ttocali/rssi-raspi/Website/Final Report/README.txt

Alpha by HTML5 UP
html5up.net | @n33co
Free for personal and commercial use under the CCA 3.0 license (html5up.net/license)

A clean, super minimal responsive template geared towards startups, app devs, and other
dedicated folks working tirelessly to launch their products. Includes a landing page,
generic page, contact page, and a page with a whole mess of pre-styled elements (something
new I'm trying out). Sass sources are also included.

Demo images* courtesy of Unsplash, a radtastic collection of CC0 (public domain) images
you can use for pretty much whatever.

(* = Not included)

Feedback, bug reports, and comments are not only welcome, but strongly encouraged :)

AJ
n33.co @n33co dribbble.com/n33

PS: Not sure how to get that contact form working? Give formspree.io a try (it's awesome).

Credits:

	Demo Images:
		Unsplash (unsplash.com)

	Icons:
		Font Awesome (fortawesome.github.com/Font-Awesome)

	Other:
		jQuery (jquery.com)
		html5shiv.js (@afarkas @jdalton @jon_neal @rem)
		CSS3 Pie (css3pie.com)
		background-size polyfill (github.com/louisremi)
		Respond.js (j.mp/respondjs)
		Skel (skel.io)
