ttocali/rssi-raspi/Website/Final Report/index.html

# On-Campus Lost and Found by Christine Hwang and Tania Tocalini

## On-Campus Lost and Found

Christine Hwang (ch458) and Tania Tocalini (tvt9)
May 18th, 2016

## Objective

Our objective was to design and implement indoor localization with the Pi. We accomplished this goal through Wi-Fi using fingerprinting. Because universities have broad Wi-Fi networks, we decided that indoor localization would best be used to help users detect which floor and building their lost objects are in.

## Introduction

Indoor Wi-Fi localization is a fascinating topic to research as there are so many different ways to implement it. Since the Raspberry Pi is a powerful computer, we believed that it would be a good tool to discover how to implement an indoor positioning system. Having a working indoor positioning system on campus would also be incredibly useful if we could apply it to locating easily lost items such as umbrellas, wallets, or keys. For our current goals, we chose to design a system that would be able to identify which building and floor the item is located in. This system would use a client-server model with the Raspberry Pi as the main server and Wi-Fi tags on the lost items as the clients. For the client-side, we used the Huzzah breakout board provided by Adafruit as the tag. For the server-side, we executed indoor localization with fingerprinting after researching and considering several different methods. As proof of concept, we have implemented a system that can only detect one lost item in Phillips Hall for now but we hope to be able to expand this system to be able to detect multiple lost items campus-wide.

## Design and Testing

### Background Research

Because there are so many ways to implement indoor localization through Wi-Fi, we took some time to research which method was most feasible for our purposes. Specifically, we investigated the methods of Wi-Fi trilateration, triangulation, distance-vector hop node localization and scene anaylsis for fingerprinting. Written below are simple overviews of each of these localization methods. For more details on trilateration, triangular and scene analysis, refer to Martin van de Goor's paper (http://www.cs.ru.nl/D.Jansen/MartinVanDeGoorScriptie.pdf). For more details on Distance-Vetor Hop Node localization, refer to Anil Agashe, Amrita Agashe, and Dr. Patil's paper (http://ieeexplore.ieee.org/stamp/stamp.jsp?arnumber=6295757).

#### Trilateration

For two dimensions, trilateration determines an object's position using the intersection of the object's distances from three access points in the same plane. With Wi-Fi, the distances can be calculated using the free-space path loss concept from physics. As discussed in Ryan Miller's blog (http://rvmiller.com/2013/05/part-1-wifi-based-trilateration-on-android/), the free-space path loss is a relation between the distance and the RSSI (Received Signal Strength Indicator) and frequency of the signal from the access point as seen in the Equation 1. Note that the constant -27.55 depends on the units. For this equation, we are assuming that frequency is in MHz and distance is in meters.


Equation 1: Free-Space Path Loss

Typically, the distances from the nodes are assumed to be circles for more accuracy, but can be done using squares as well for simpler computation.

#### Triangulation

Triangulation is similar to trilateration, but instead of requiring distances between the object and three nodes, it requires one known distance between two nodes and the angles between each of these nodes and the object. In Wi-Fi triangulation, the measurement of the angle can be determined with the angle of arrival (AoA) method. The AoA method requires that the nodes measure the difference in arrival times of a signal and also needs to know the geometry of the node array.

#### Distance-Vector Hop Node Localization

Also known more commonly as the DV-Hop, this algorithm returns the distance of unknown objects to known nodes by computing the product of the average hop distance and the hop count. Trilateration can then be used to estimate the position once three of these distances have been computed.

#### Main Drawback to These Methods

The main drawback to the previous methods is that they all require knowing the physical location of the access points on campus. Interestingly enough, there actually are potential databases that we could use to find the location of a router shown in the table borrowed from Wikipedia's Wi-Fi Positioning System (https://en.wikipedia.org/wiki/Wi-Fi_positioning_system#Public_Wi-Fi_location_databases) page.

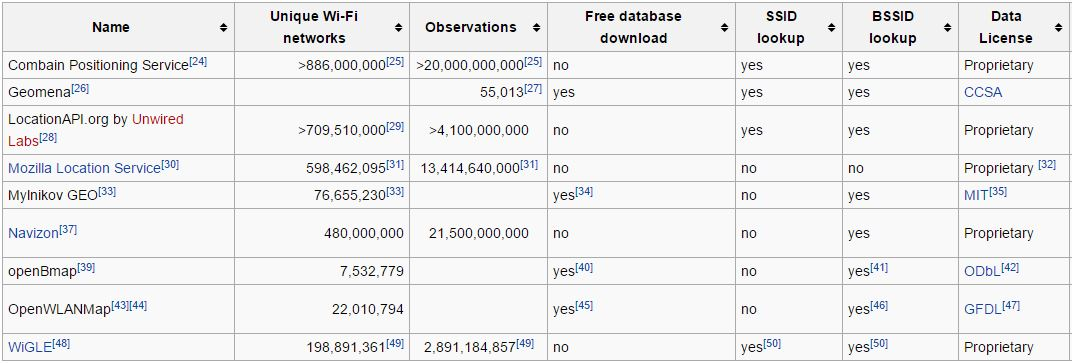
[picture p1: Website/Final Report/images/DatabaseTable.JPG]

Figure 1: Public Wi-Fi Location Databases

Unfortunately, none of these available databases allowed us to access the exact location of the access points. Instead, they were all blackbox APIs that returned an approximate locations, which were useful to determine the building the object is in but nothing more specific than that, which is why we ended up using the last method of scene analysis or fingerprinting as that was the most feasible. Note, only some of the databases were viable because their API allowed us to look up locations based on BSSIDs we collect from the access points.

#### Scene Analysis and Fingerprinting

Scene analysis determines a location based on what can be sensed or observerd around the target. This requires a learning phase before any localization can be done. The learning phase generally collects and maintains a database of the categorized observed information. In our case, we used fingerprinting to collect data on router WiFi access points. Fingerprinting essentially takes a snapshot of the observed data and labels it with the appropriate tag, e.g. location such as Phillips Floor 2. The more fingerprints you have the larger the scope of analysis can be and more accurate you can determine location. In the localization phase, scene analysis then takes in everything the target is observing and matches it against the recorded fingerprints to find the location of the target. We decided to use this to design our system because we had no information on the location of routers. With this system we could collect fingerprints and assign each to a general location. Thus, during the learning phase, we "learned" the locations of the routers. Afterwards we were able to use this to determine the location of the target.

### Overview

The On-Campus Lost and Found works as a client-server model. Each easily lost item would be attached with a Wi-Fi tag (shown in Photo 1) that would act as the client by observing the networks around it and sending necessary data to the Pi server.

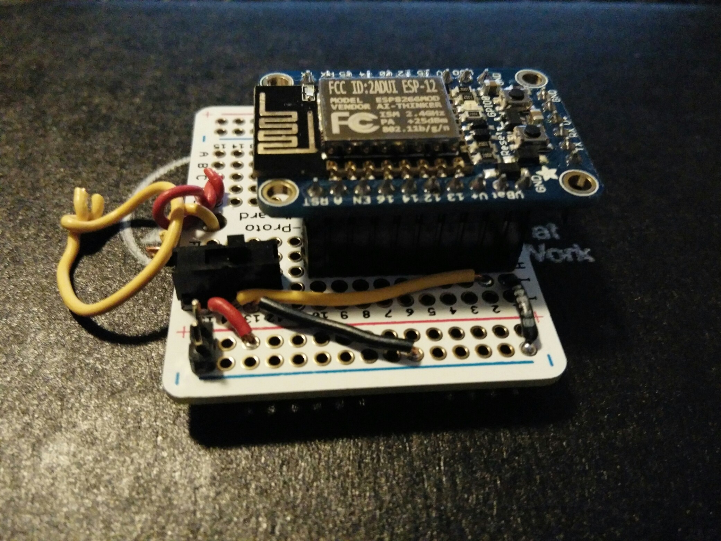
[picture p2: Website/Final Report/images/HuzzahTag.jpg]

Photo 1: Wi-Fi Tag

As discussed in the previous section, the system has two states: a Learning state and a Tracking state. Both states follow the same model in Figure 2.


Figure 2: Overview of On-Campus Lost and Found

#### Learning

Before the Pi can locate any lost item, it needs to map out the necessary buildings. In order to do this, the server has to be configured into the Learning state. The server will then ask the user for the building and floor. After answering this question, the user needs to walk around the desired floor with the tag. As they walk, the tag will send an array every two seconds of the IP address of the Huzzah and the BSSIDs of the three networks around the tag with the strongest RSSI signals as well as the RSSI signals themselves. The server will then store this information in a database matching the combination of BSSIDs and RSSIs to a floor. This will need to be done for each building and each floor the user wishes to map.

#### Tracking

When the user is satisfed with their mapping, they can then start tracking their item. While the system is idle, the server would simply display a red button labeled "PANIC!" as the user supposedly hasn't lost their item yet. When the user has lost their item, though, they will then press the button in panic. Hopefully, their item is still on campus and if so, then the server will be able to locate the item and display the building and floor on the screen by querying the newly made database. Once the item has been relocated, the user can reply to the server that they have found the item by hitting the "I'm OK" button. This will return the server to the idle state again. These two server states can be seen in Photo 2.

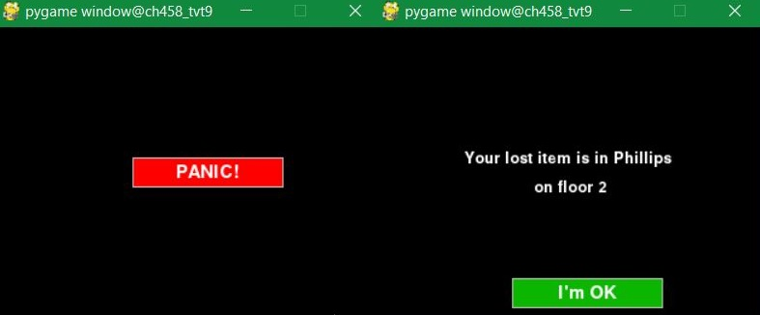
[picture p3: Website/Final Report/images/ServerStates.jpg]

Photo 2: Pi Server Before and After Item is Lost

### Server-Side

There are 4 main components on the server-side for this system: communication layer, fingerprint database, graphical user interface, and modes of operation, i.e. learning and tracking.

In the communication layer, we currently have a simple socket connection server, hosted on the Raspberry Pi. It expects communication following UDP protocol. We chose UDP over TCP because we had planned on having fast continuous communication between the server and client. Assuming the item has been lost and isn't moving, we don't need to know every single snapshot of data. As long as we receive semi-frequent data, the server is able to approximately locate the client. We can afford to trade off reliability of data and connection for speed and simple design. We discovered that on public WiFi networks, such as RedRover, we are able to piggyback the network and bypass registration to still use the WiFi for socket communications with our server. We did nothing extra to make this happen. It simply worked once we set up a socket communication. Note, if you try to access web pages without registration, you won't get the contents of the web page, but instead a message asking the user to register.

The most critical portion of this system is the fingerprint database. We use a database to keep track of router WiFi access points within a mapped area. During the learning phase, we collect BSSID and the associated RSSI, building name, and floor number. The database then creates a table for each mapped building. BSSIDs are assumed to be a unique entry for each table, so we use this fact to quickly find information about any access point. For each entry we keep the average of encountered RSSI signal strength for a floor and the number of times we have encountered this WiFi access point. Keeping the average helps to stabilize our information for each access points by eliminating outliers caused by an obstacle-free line of sight for a signal. We currently keep track of the number of times we encounter an access point, but don't use this information in our analysis. The plan for the future was to design a finer grain algorithm that would be based on a combination of RSSI, number of times encountered, and locations of analysis. We also keep track of the floor for each BSSID. The floor number is determined by the RSSI. The floor with the highest RSSI is the one that wins and is put into the database. Note, this does not imply that the router is actually on that floor. It simply means that if we were to receive a signal from that WiFi point again, we're most likely to be on the stored floor. Overall, our "fingerprint" consists of a BSSID with the associated RSSI, number of times seen, and floor number. Fingerprints are aggregated per building in our database. This was written and maintained using sqlite.

As shown in a previous section, we designed a graphical user interface for tracking an item. The interface is designed to display the location of the item, whenever the user chooses to see the location. Otherwise, the GUI is idle and doesn't display any useful information.

Our backend has three modes of operation: learning, tracking, and idle. Both learning and tracking were described in previous sections. Both operations are executed separately from the server. The server can then be on and running no matter the mode of operation. We use a fifo between the server and the operations to communicate data from the server to the algorithms. The learning script may update the database based on the data passed on from the server. The tracking script will under no circumstances update the database. It simply takes the BSSID passed on from the server and queries the database to get the corresponding building and floor.

### Client-Side

#### Hardware

The tag we use to scan the surrounding networks is Adafruit's Huzzah breakout board (https://www.adafruit.com/product/2471). As seen in the photo below (borrowed from the Adafruit website), it's about the size of a quarter, a good size to use for a tag.

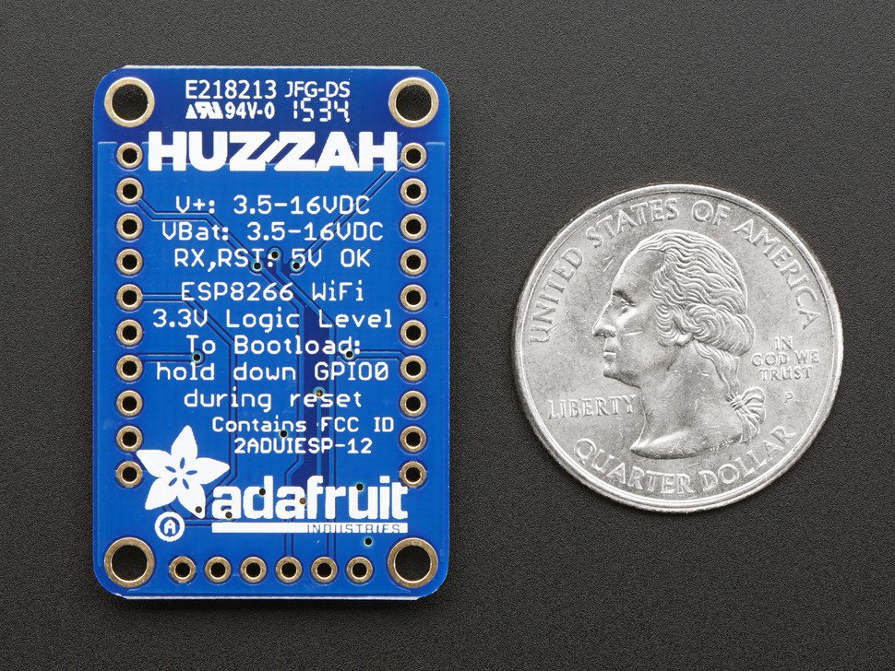
[picture p4: Website/Final Report/images/2471-13.jpg]

Photo 3: Comparison of Huzzah Board to Quarter

After receiving the Huzzah, we soldered the headers onto the board. By accident, we soldered the programming header incorrectly. Instead of facing upwards from the board, we soldered it facing downwards similar to the other two headers. This made it impossible to put it into a breadboard unless the Huzzah was placed at the edge. This later turned to be a benefit, however, by reducing the height of the tag.

Since this was a tag separate from the Pi, the Huzzah needed its own power supply. For power sources, we were originally going to use coin batteries because they were small, light and cheap. However, we were afraid that the coin batteries would not be able to supply enough current to the Huzzah. According to Adafruit's tutorial (https://learn.adafruit.com/adafruit-huzzah-esp8266-breakout/pinouts), the Huzzah needed a supply that provides at least 3.3V and 500mA of current, so we decided to buy a 3.7 lithium ion polymer battery (https://www.adafruit.com/products/1578) that could supply up to 500mA. The reason we did not consider using a typical 6V AA battery pack is because they are too heavy and would have weighed the tag down compared to the much lighter lithium ion battery. An additional note about the lithium ion battery is that they can be recharged and reused as long as you have the corresponding charger (https://www.adafruit.com/products/1904).

To keep the tag portable, we bought the smallest perfboard available (https://www.adafruit.com/products/1608) (1/4 size). On the front side of the board, we soldered two 10-pin female-to-male headers to attach the Huzzah to the board, a SPDT switch to control the power supply, a 2-pin male header to connect the battery to the board, and wires to connect the power supply to their respective pins on the Huzzah (mainly the VBat and GND pins). We used headers to connect the Huzzah to the perfboard instead of directly soldering the Huzzah to the board so that the Huzzah would be easy to replace in the case that we accidentally killed the chip. On the back side of the board, we put velcro so that the battery can be easily attached. We also inserted wires into one of the mounting holes of the perfboard and molded them into a key ring as a possible idea on how to attach the tag onto an item. The final product turned out to be a portable tag with a size of 1.7" x 2.0" x 0.9" that can easily be turned on and off as seen in the following photos.

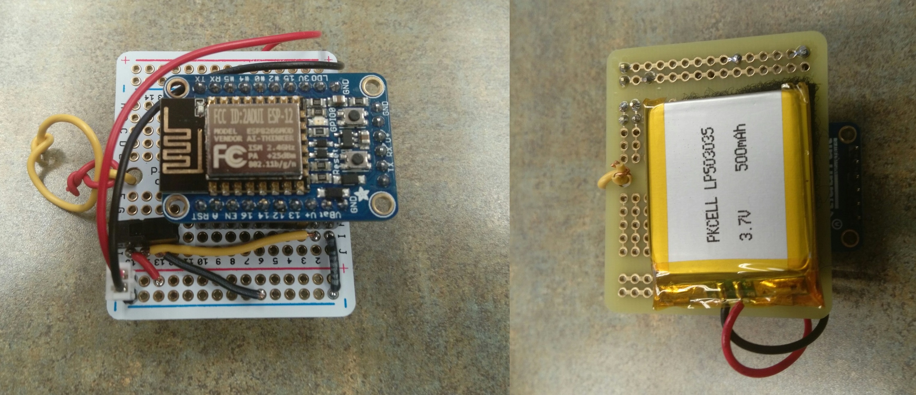
[picture p5: Website/Final Report/images/HuzzahBothSides.jpg]

Photo 4: Huzzah Tag Front and Back Sides

#### Software

There are two main methods to program the Huzzah: NodeMCU Lua and the Arduino IDE. Due to familiarity and simplicity of use, we programmed the Huzzah with a USB to TTL Serial Cable (https://www.adafruit.com/product/954) and the Arduino IDE (https://www.arduino.cc/en/Main/Software). The client code written for this project is attached in the Code Listings section of the Appendix as Client.ino.

As mentioned earlier, the tag needs to be able to send an array containing its current IP address and the BSSIDs of the top three routers and their corresponding RSSIs to the server every 2 seconds. Convieniently, the Huzzah is an ESP8266 chip and therefore comes with the ESP8266WiFi library, which includes many functions needed for this project. In particular, we found the WiFi.scanNetworks() and WiFi.getNetworkInfo() functions to be useful.

During initialization, the Huzzah will boot up and first connect to the university's main network. In our case, we connect the tag to Cornell University's RedRover Network as it is one of the largest open networks on Cornell. Once connected, it will then connect to the server and then obtain and store its current IP address into the client array. It will also setup an LED to blink every 30 seconds. The purpose of the LED is to check on the battery life. If the power supply is below 3.3V, the Huzzah won't function correctly and so the LED will fail to flash.

After everything is set up, the Huzzah will proceed to enter a loop. It scans the networks using WiFi.scanNetworks to record the number of discovered networks. Then, it will get various information through the WiFi.getNetworkInfo() function about each network namely the SSID, encryption type, RSSI, BSSID, channel, and whether the network is hidden or not. For this project, we are mainly concerned about the BSSIDs and RSSIs and so we store these values into two large arrays containing the BSSIDs and RSSIs of all the networks. While this program runs, the Huzzah needs to be able to identify the three networks with the strongest signals. When scanning the networks, though, the returned list of networks may not necesarily be in any specific order. Thus, we perform an insertion sort (as we are not too concerned about speed in the program) to sort all the RSSIs and their corresponding BSSIDs in order from strongest to weakest signal to record the top three BSSIDs. After the top three networks are found, the Huzzah stores these BSSIDs and RSSIs into the large client array as seen in Figure 2 and then sends this array to the Pi server.


Figure 2: Format of Client Array (34 bytes total)

### Testing

Testing the project initially was straightforward. As this was a software-heavy project, we mainly printed variables to the screen to debug the code. Note that on the Huzzah side, these prints must be commented out once debugging is completed. If not, the Huzzah program will not run when unplugged from the computer because it won't be able to connect to the serial monitor.

Testing the actual implementation was more complex. Before the Pi can track anything, it had to learn a building first. For verification purposes, we used floors on Gates and Phillips Hall. Since there were some server-client communication issues, one person would roam the floor with the Huzzah. On the other side, the second person would keep an eye out on the command line to ensure that no communication errors happened between the Huzzah and the Pi. If a problem did arise, the second person would contact the first person by phone to let them know that they can stop. Communications between the Huzzah and Pi would then be reset so that the first person can continue their fingerprinting quest. Similarly, for tracking, one person would be walking around with the Huzzah while the second person would be at the server. The server would print the determined location of the Huzzah. We could easily verify whether the system was working then by seeing if the determined location matched the actual location.

### Issues

While we were working on this project, we did encounter several mysterious issues dealing with the Pi and Huzzah. Sadly, we were not able to diagnose the cause nor come up with a fix for most of these issues.

One of the main issues was when our first Pi had mysteriously died. This occured after we had plugged it into one of the walls in Statler For troubleshooting the Pi, we referred to elinux's R-Pi_Troubleshooting (http://elinux.org/R-Pi_Troubleshooting) page. The Power LED didn't light up for this Pi after plugging it into Statler and when we attempted to communicate with the Pi through the FTDI cable, the computer claimed that there was the Pi required too much power that the USB port couldn't provide. We suspect that the Pi may have died after a power surge in Statler, but are unsure if that is the true source.

Hence, we obtained a second Pi, but this Pi turned out to be faulty as well. Even though the Power LED lit up this time, the ACT LED did not flash as it was supposed to show SD card interaction and instead remained on after the Pi booted. The piTFT display also remained lit up and never booted. We isolated the problem as the Pi itself. To eliminate other possible causes, we plugged it into the monitor to remove the piTFT screen and we input in a SD card that had worked on another Pi, but this Pi still did not boot up. As this Pi was a new Pi, we believe that the Pi may have been defective right out of the box.

Now that we had two Pis dead, we found that our touchscreen had completely died as well. Actually, the touchscreen had been a constant issue before this project. In a working system, /dev/input/touchscreen would be mapped to event2. Ours, though, had a tendency to map to rfkill. This issue used to be alleviated by running a Bash script in the .profile that would ensure that /dev/input/touchscreen was mapped to event2, but this script stopped working as the Pi would display that the only thing /dev/input/touchscreen would map to was rfkill. Even after we obtained a new piTFT screen, we were unable to fix the problem. We speculate that the cause may be somewhere in the configuration stored on the SD card, but were unable to fix it in time to make our touchscreen GUI work for the demo.

Another bug that we had was miscommunication between the Pi and Huzzah. When the Huzzah is turned on, we expected that it would automatically connect with the server if the server is online but it doesn't. Instead, we needed to leave the Huzzah on, close and reopen the server, and reset the Huzzah to restore communications. It is still unknown whether this issue is due to the server or due to the client.

The final unsolved issue was transferring variables between Python files. We wanted to be able to identify the correct building and floor in tracking.py and reveal this location on the screen in gui.py. According to the Python FAQ (https://docs.python.org/2/faq/programming.html#how-do-i-share-global-variables-across-modules), we simply had to write a third module and import it in both files to have global variables between modules, which is why our code also includes a location_me.py. Despite following the instructions, though, the variables in location_me.py remained unchanged in gui.py even though they were changed in tracking.py. Without being able to connect the two modules, we were unable to complete the desired GUI for this project even without the touchscreen functioning.

An issue early on that we had and were able to solve was getting the Huzzah to connect to Cornell University's RedRover Network. Following Cornell's instructions on how to register a device without a browser (http://www.it.cornell.edu/services/wifi/register-nobrowser.cfm), we found that the Huzzah was still unable to connect to the network correctly. Below are some images detailing a successful connection versus the unsuccessful connection to the Internet. Luckily, we did not need to worry about this issue too much, because we could still connect to the server through a direct socket connection despite not being able to connect to the Internet. After some further reflection, it is possible that we registered the wrong MAC address. While testing our project, we found that the Arduino examples printed the obtained BSSIDs in reverse so this may be the case as well with the MAC address.

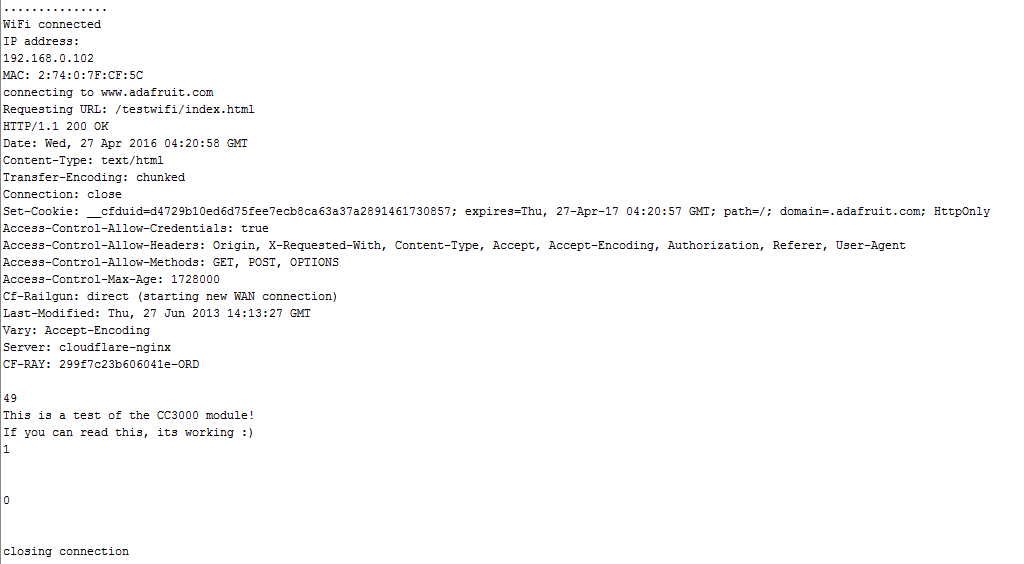
[picture p6: Website/Final Report/images/successful_connection.PNG]

Figure 3: Successful Connection Between Huzzah and Network

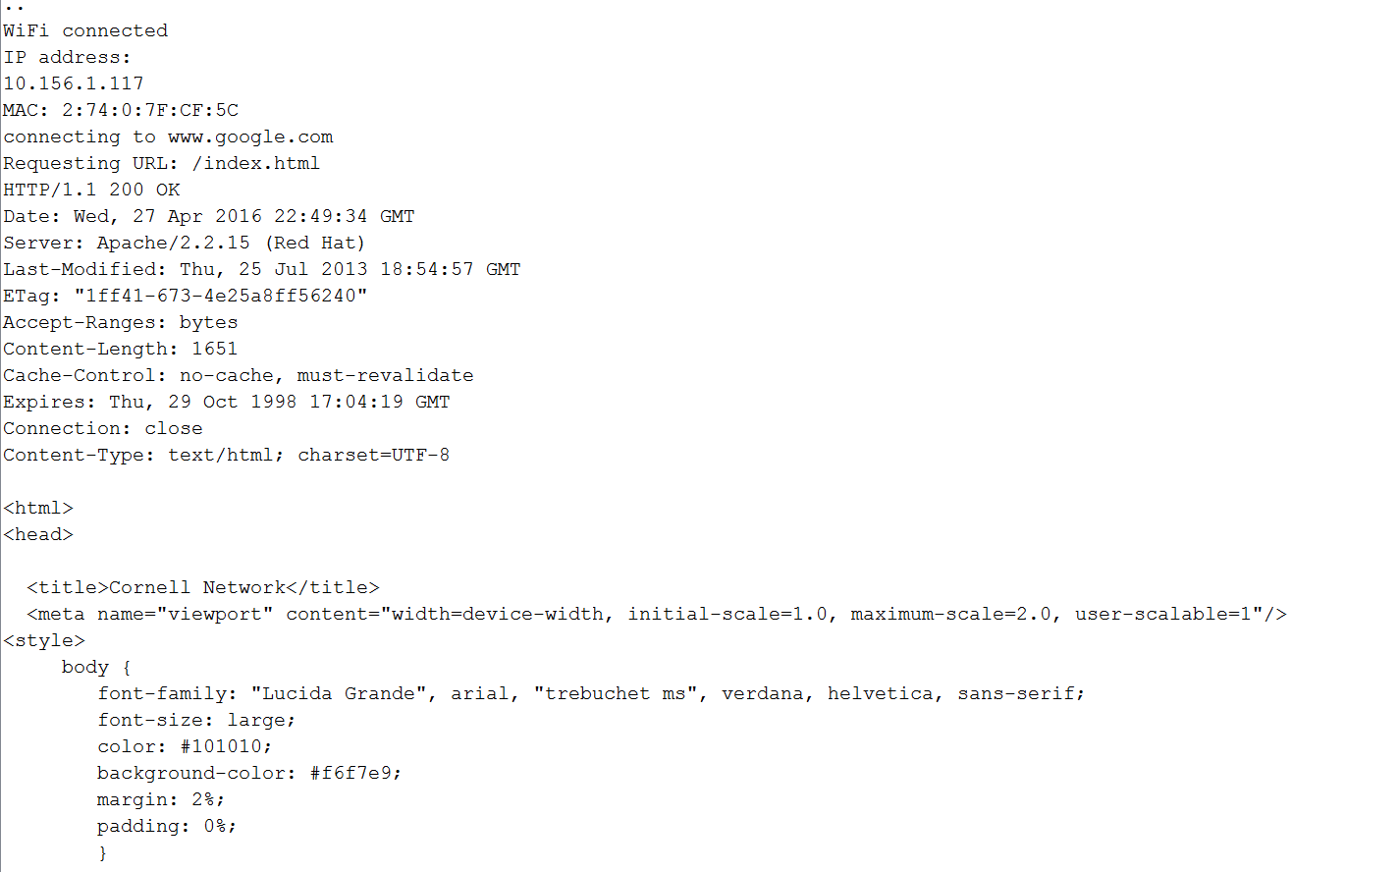
[picture p7: Website/Final Report/images/failed_connection.PNG]

Figure 4: Failed Connection Between Huzzah and Network

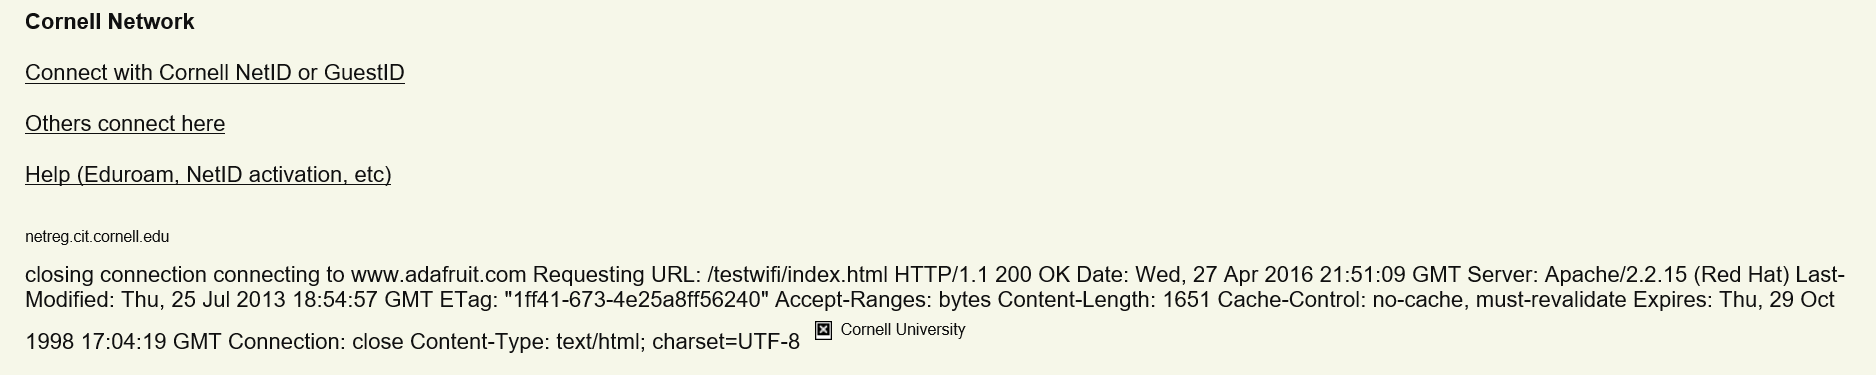
[picture p8: Website/Final Report/images/html_screenshot.PNG]

Figure 5: HTML Display of Error Message

Another issue we encountered and were able to solve was pinging the Pi. We found that this was a known issue and could easily be fixed by running the sudo chmod u+s /bin/ping command.

## Results

Our expectations at the beginning of this project was to design a system that would be relative to the position of the Raspberry Pi. After doing some research, we discovered that this is impossible (at the moment) to achieve without having some knowledge of the locations of routers or specific expensive hardware to measure the location. We switched over to a different system altogether that relies on building a collection of fingerprints of known routers and associated locations and then using that information to find the area a tag is in. This system is not easily scalable because it has a learning phase that maps places which involves going to the physical location and walking around with our tag to collect fingerprints. Additionally, maintaining an accurate database of fingerprints is difficult. Fingerprints can become stale if a router moves position or a new wall is built. New routers can be added to an area that we won't have a fingerprint to. We did succeed in accurately determining the difference between floors in a building. This was measured in Duffield between floors 2, 3, and 4. We discovered that the moment a user with the tag stepped onto floor 3 from floor 2, our server would immediately display Floor 3 as the location. Furthermore, while wandering on the floor our server always displayed the correct floor. This sometimes depended on how fast the person holding the tag walked. Our communications between the server and Huzzah ran at 0.5Hz, so the Huzzah sent data over to the server every 2 seconds. 2 seconds is too slow to accurately and immediately determine location for a moving target. We were unable to test faster frequency for communication. Otherwise, we would have chosen the fastest frequency that still functionally operated well. Ideally, we would want this to run between 30-60Hz for moving targets. However, the reason we were testing with lower frequency was because we assumed that once lost, an item is immobile and thus did not need to send data so often. While testing, we realized that 0.5Hz is impractical while collecting fingerprints during the learning phase.

## Conclusions

With our limited means, this design is impractical for a "lost and found" scheme because of scalability issues. We aren't able to find the object if it was lost in a place that has not been mapped in our database. However, with enough time, we could potentially map all of Cornell Campus and have this system work for on campus item detection. We did succeed in accurately determining location in terms of building and floor. Ideally, we'd like to expand the project and collect fingerprints for rooms as well as floors. This way our "lost and found" scheme can be accurate down to the room. Determing the room a router will be mapped to is an issue since signals can span several rooms. However, this is also an issue for floors and we were able to successfully categorize signals that spanned multiple floors.

## Future Work

There is a lot of potential work that could be done to expand this project into a useful tool that could really be used on campus if we were given more time to work on this project. These involve fixing the current bugs, looking into better alternatives for tags, and expanding this into a full blown project by mapping out all campus buildings and rooms.

First and foremost would be more work to debug our current project into a robust system. Basically, we need to diagnose and resolve the previous bugs of the server-client miscommunication, nonfunctional touchscreen, and global variables between multiple Python modules. These bugs must be fixed before we can move along with the project.

Earlier, we discussed that the Huzzah also sends the IP address along with the BSSIDs and RSSI signals. This is because we were originally going to use the IP address and the BSSIDs to access the public Wi-Fi location databases through APIs and obtain a latitude and longitude. The latitude and longitude could be used to find the building an item was in, which we would use to pull up a map. With a finer graned localization algorithm, we could then reveal to the user exactly where their item is in a map of the building.

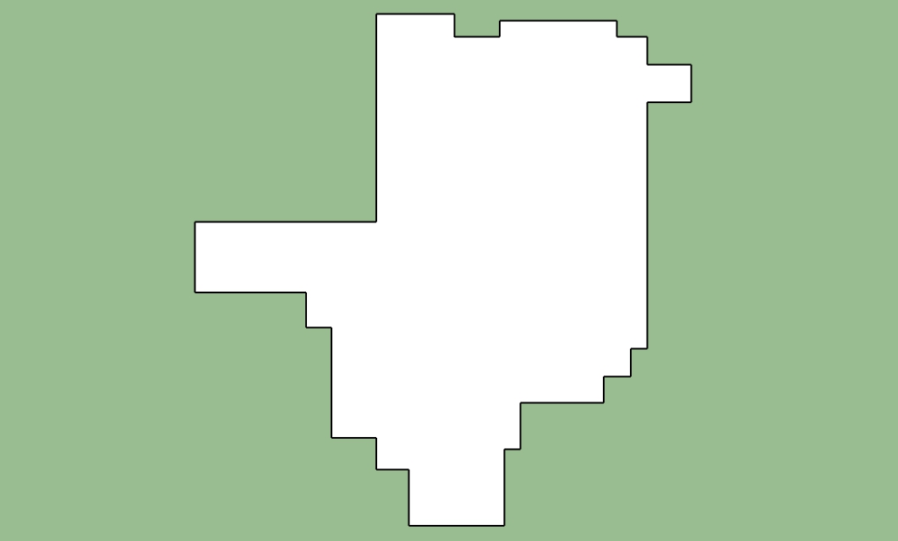
[picture p9: Website/Final Report/images/philips.jpg]

Figure 6: Building Map for Phillips and Duffield

At this point, we have created a decent working system. Price-wise, though, it is still a bit high as each tag is about twenty one dollars (Huzzah, perfboard, and battery). Researching online, we should look into testing and using the ESP8266 ESP-12 Wi-Fi Serial Module (http://www.gearbest.com/transmitters-receivers-module/pp_227650.html?wid=8) in place of the Huzzah. For this project, we only needed to be able to use a chip that can utilize the ESP8266WiFi Arduino library. The Huzzah can do this, but it also comes along with unnecessary GPIO and a much higher price compared to the more cost-effective and smaller Wi-Fi serial module. Because the Wi-Fi serial module is smaller, we can also look into designing smaller PCBs and researching power sources other than the Li-Ion battery to see if we can make our tag more portable and affordable.

Assuming that the new WiFi serial modules work, the project would be at a more affordable budget, which means that we could start considering expanding the system to work with multiple lost items. This requires additional work to make the system multi-threaded so that it can connect to multiple tags instead of one tag only. Having multiple tags would also require that we improve on server interaction with the user. Before the server can start tracking, the user would need to register with the server which objects are attached to the tags. Then, in Tracking mode, the server will still diplay the PANIC! button, but after the user has hit the button, the GUI will ask the user to identify which item was lost before displaying that specific item's location.

Finally, we would be in a good place to scale our project to work on the entire campus when we get multiple object location functioning. To conclude our project, we would pass several tags to various friends to learn and expand the server's database so that it can track any object anywhere on campus.

## Appendix

### Code Listings

Server-Side
server.c (https://github.com/ttocali/rssi-raspi/blob/master/server/server.c)
db_functions.py (https://github.com/ttocali/rssi-raspi/blob/master/server/db_functions.py)
learning.py (https://github.com/ttocali/rssi-raspi/blob/master/server/learning.py)
tracking.py (https://github.com/ttocali/rssi-raspi/blob/master/server/tracking.py)
gui.py (https://github.com/ttocali/rssi-raspi/blob/master/server/gui.py)
location_me.py (https://github.com/ttocali/rssi-raspi/blob/master/server/location_me.py)
Buttons.py (https://github.com/ttocali/rssi-raspi/blob/master/server/Buttons.py)

Client-Side
client.ino (https://github.com/ttocali/rssi-raspi/blob/master/HUZZAH/client/client.ino)

### Bill of Materials

Part | Vendor | Part Number | Unit Price | Quantity | Total Cost per Part
Huzzah | Adafruit | 2471 | $9.95 | 1 | $9.95
USB to TTL Serial Cable | Adafruit | 954 | $9.95 | 1 | $9.95
1/4 Sized Protoboard | Adafruit | 1608 | $2.95 | 1 | $2.95
3.7 V Li-Ion Battery (500 mAh) | Adafruit | 1578 | $7.95 | 1 | $7.95
MicroUSB to Li-Ion Battery Charger | Adafruit | 1904 | $6.95 | 1 | $6.95
Total: | | | | | $37.75

### Server References

Sockets Tutorial (http://www.linuxhowtos.org/C_C++/socket.htm)
Indoor Localization in Wireless Sensor Networks (http://www.cs.ru.nl/D.Jansen/MartinVanDeGoorScriptie.pdf)
Wi-Fi Trilateration on Android (http://rvmiller.com/2013/05/part-1-wifi-based-trilateration-on-android/)
DV-Hop Localization Algorithm (http://ieeexplore.ieee.org/stamp/stamp.jsp?arnumber=6295757)
Public Wi-Fi Location Databases (https://en.wikipedia.org/wiki/Wi-Fi_positioning_system#Public_Wi-Fi_location_databases)
Converting Python Integers into Signed 32-bit Equivalents (http://www.neotitans.com/resources/python/python-unsigned-32bit-value.html)
Ping Issue on Raspberry Pi (https://www.raspberrypi.org/forums/viewtopic.php?f=91&t=128458&p=859002)
Raspberry Pi Troubleshooting (http://elinux.org/R-Pi_Troubleshooting)

### Client References

Huzzah Breakout Board Tutorial (https://learn.adafruit.com/adafruit-huzzah-esp8266-breakout/overview)
Device Registration Without Browser (http://www.it.cornell.edu/services/wifi/register-nobrowser.cfm)
Arduino Wi-Fi Library (https://www.arduino.cc/en/Reference/WiFi)
Arduino ScanNetworks Example (https://www.arduino.cc/en/Tutorial/ScanNetworks) Arduino IDE (https://www.arduino.cc/en/Main/Software)

### Vendor Sites

Adafruit (https://www.adafruit.com/)

### Acknowledgements

We'd like to acknowledge and thank our professor, Joe Skovira (http://skovira.ece.cornell.edu/), as well as the three TAs, Gautham Ponnu, Jacob George, and Jingyao Ren for their guidance and advice.

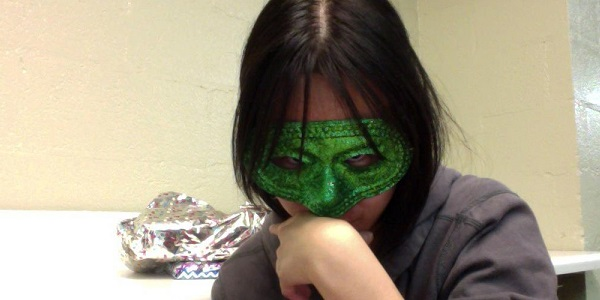
[picture p10: Website/Final Report/images/860107_10151298041051169_468712386_o.jpg]


### Christine Hwang (ch458)

• Huzzah board design and assembly
• Software - Client-Side
• Website Organization

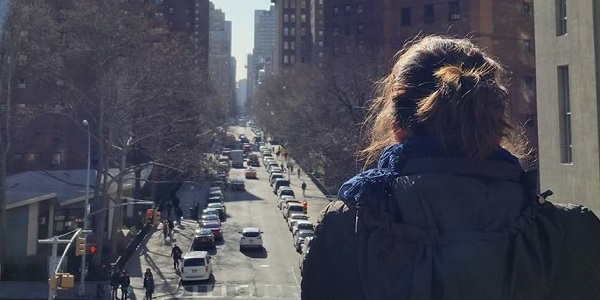
[picture p11: Website/Final Report/images/12376866_770815203018216_5419212314433199246_n.jpg]


### Tania Tocalini (tvt9)

• Background Research
• Aesthetic Opinion
• Software - Server-Side

- Github (https://github.com/ttocali/rssi-raspi)
- © Untitled. All rights reserved.
- Design: HTML5 UP (http://html5up.net)
