ttocali/rssi-raspi/Website/Final Report/images/HuzzahBack.jpg

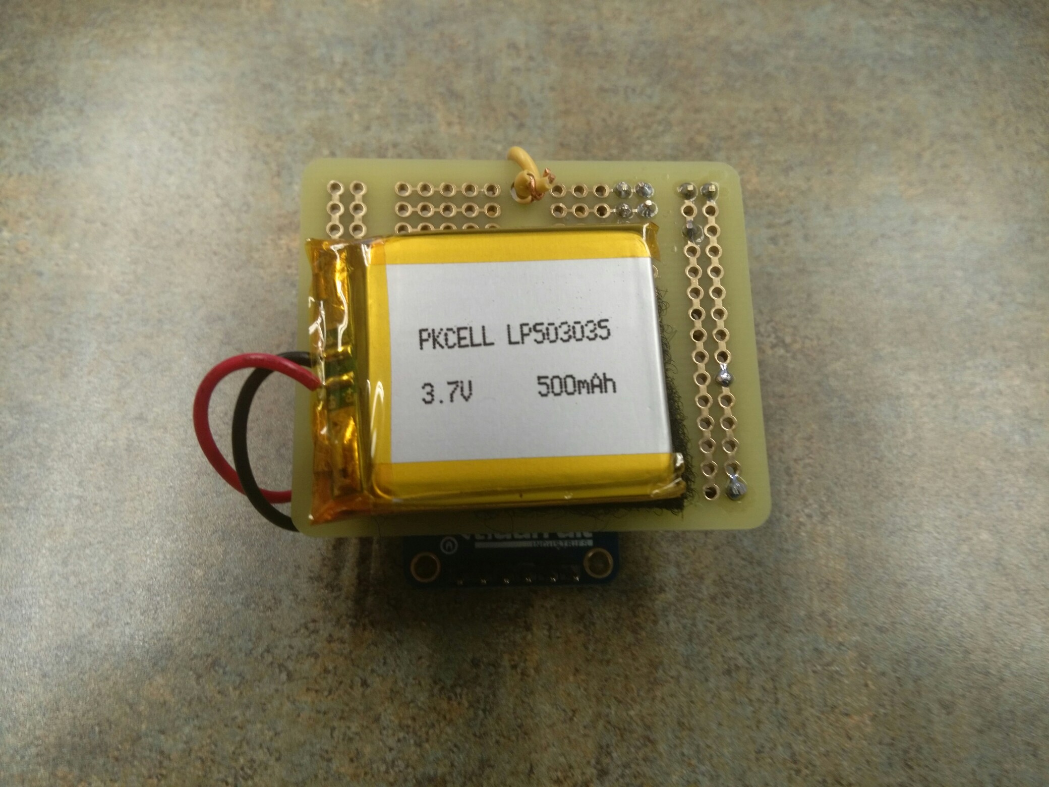
Website/Final Report/images/HuzzahBack.jpg
