ttocali/rssi-raspi/Website/Final Report/images/HuzzahOff.jpg

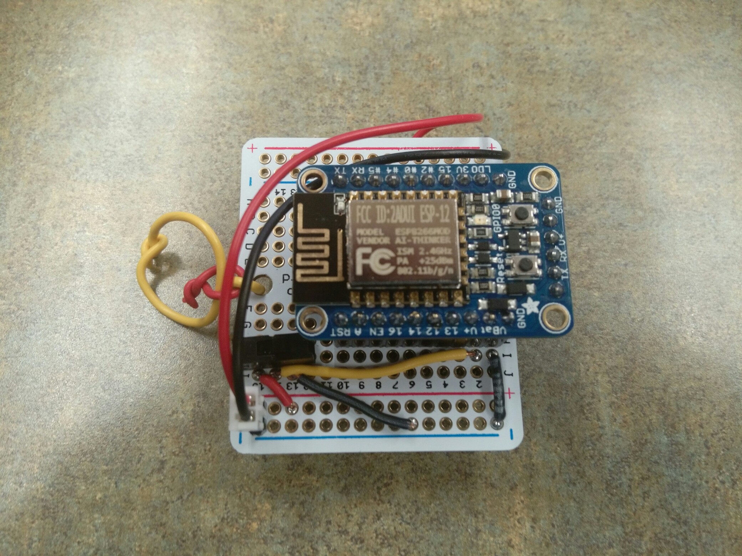
Website/Final Report/images/HuzzahOff.jpg
