ttocali/rssi-raspi/Website/Final Report/images/HuzzahOn.jpg

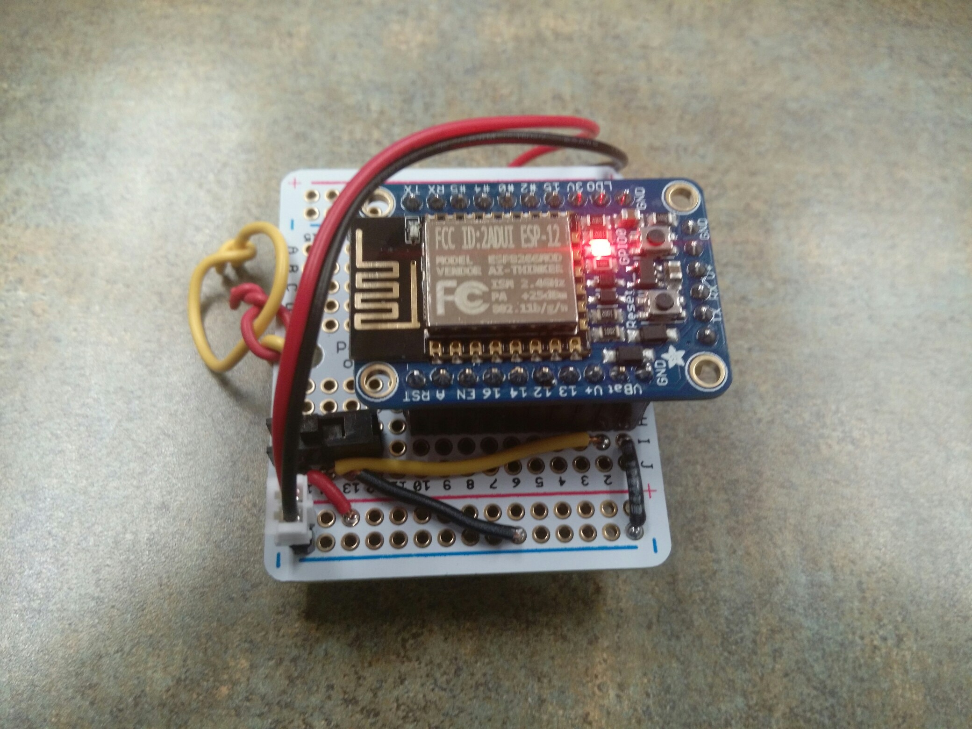
Website/Final Report/images/HuzzahOn.jpg
