ttocali/rssi-raspi/Website/Final Report/images/IMG_3657.jpeg

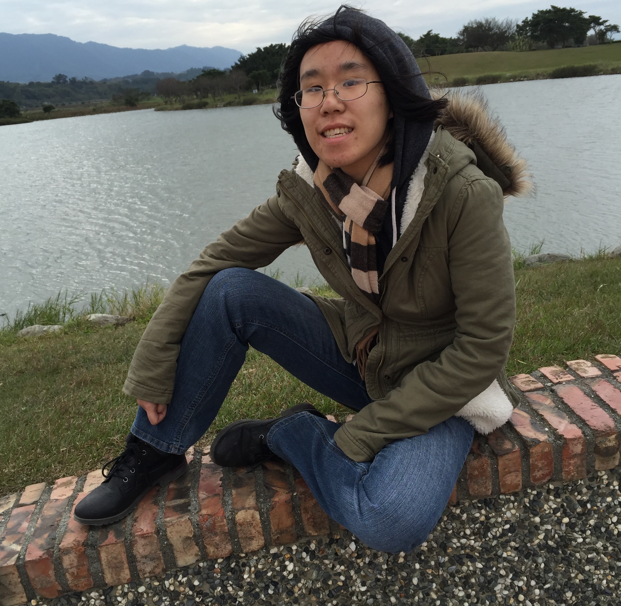
Website/Final Report/images/IMG_3657.jpeg
