ttocali/rssi-raspi/Website/Final Report/images/python1.JPG

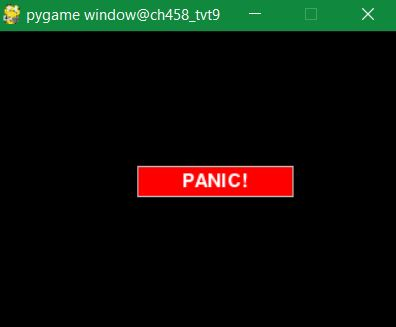
Website/Final Report/images/python1.JPG
