ttocali/rssi-raspi/Website/Final Report/images/python2.JPG

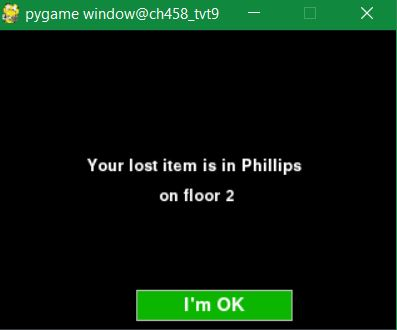
Website/Final Report/images/python2.JPG
