ttocali/rssi-raspi/Website/Final Report/images/WP_20140517_004.jpg

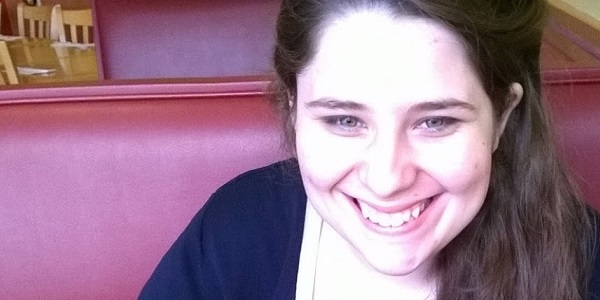
Website/Final Report/images/WP_20140517_004.jpg
