ttocali/rssi-raspi/(commit log)

2016-05-10 adding communication files for raspberry pi
2016-05-10 website and arduino
2016-05-18 adding database to contain fingerprints
2016-05-18 close sockets maybe
2016-05-18 adding gates fingerprints
2016-05-18 added averaging RSSI signals to determine overall floor strength Also, added floor logic determination, currently super simple. The better signal is chosen as the floor a signal
